colonelwatch/ESP32-dotmatrix-spectrum/(threads)

Thread 1 (2019-11-11):

Possible to use variables for num of rows / columns?

msurguy, 2019-11-11:
Hi!

I was wondering if it would be possible to make the number of rows / columns easily adjustable without rewriting a significant part of the Arduino sketch?

I see that those values are hardcoded and would like to use this program with displays that don't have the same number of LEDs as you do.

colonelwatch, 2019-11-11:
Hello! I can make a branch later with all the relevant numbers substituted. However, I don't have any other displays on hand to test, so I can't guarantee that it works. It's likely that you would need to change the flashDisplay function to suit your display if you're familiar with HUB08. What kind of specs do your displays have?

colonelwatch, 2019-11-12:
Please try the universal branch and let me know how it goes. I've attempted to test this by emulating smaller displays with the one I have. In theory this code will work if the dimensions are each a power of two and the display utilizes a 1/n scan where n = the number of rows. Otherwise, flashDisplay must be written to use R2, and a new pin on the ESP32 must be dedicated to it. Please let me know if that is the case, and I'll try that out!

colonelwatch, 2020-07-03:
I'm closing this issue because it seems to have gone stale, but whenever I happen to pick up a larger display myself, I'll update the universal branch again.
