colonelwatch/ESP32-dotmatrix-spectrum/(commit log)

2019-11-06 Raise display speed
    By increasing the SPI frequency to 40MHz the display refresh rate is increased to about 1000Hz.
    Completed page-flipping code, but it actually didn't impact the speed much
    [ESP32-dotmatrix-spectrum.ino]
2019-11-12 Edit README.md and other edits
    - Increased sensitivity, I was finding I had to turn my music way to loud for anything appealing
    - Added schematic
    - Fixed misspellings
    - Eliminated TODO section, everything in there has been done
    - Other small edits for better code readability
    [ESP32-dotmatrix-spectrum.ino]
2019-11-18 Add disclaimer to schematic
